mephi-ut/dc-thermal-logger/doc/collector/photos/IMG_20160623_171609.jpg

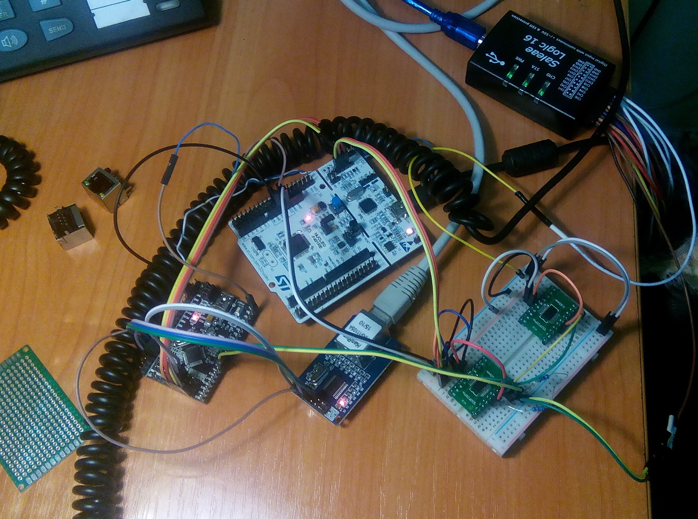
doc/collector/photos/IMG_20160623_171609.jpg
