mephi-ut/dc-thermal-logger/doc/collector/photos/IMG_20160622_171840.jpg

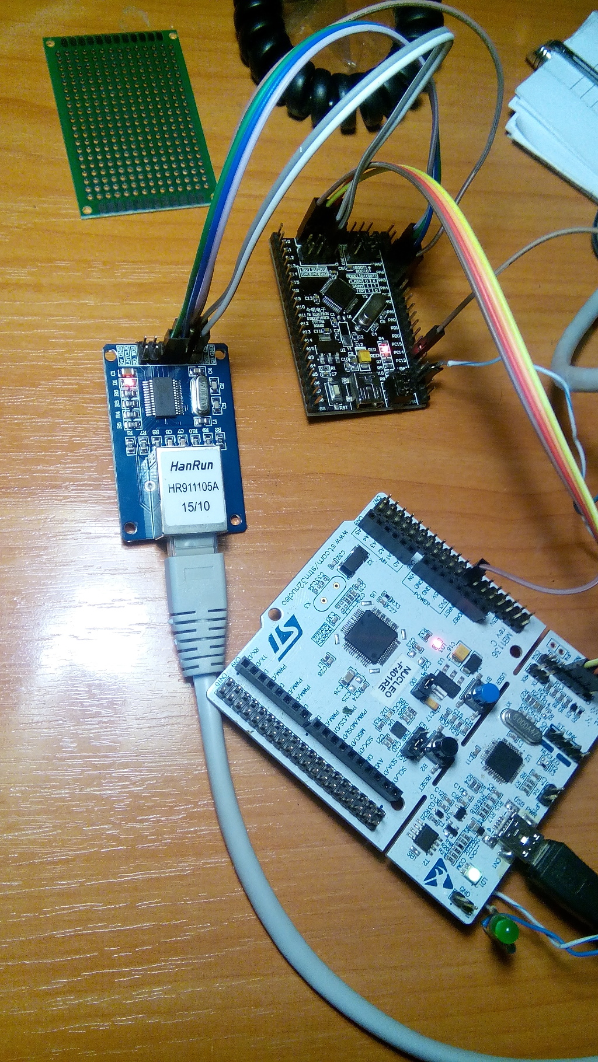
doc/collector/photos/IMG_20160622_171840.jpg
