mephi-ut/dc-thermal-logger/README.md

LICENSE: WTFPLv2

The purpose of this project is to monitor themperature in a lot of points of DC.

Operating principle:

scheme

Collector schematic:

colletor scheme

Thermal sensor schematic:

sensor scheme

A model photo:

collector photo
