mephi-ut/dc-thermal-logger/collector/firmware/firmware_Configuration.pdf

## firmware Project Configuration Report

# 1. Description

## 1.1. Project

Project Name | firmware
Board Name | firmware
Generated with: | STM32CubeMX 4.11.0
Date | 06/22/2016

## 1.2. MCU

MCU Series | STM32F1
MCU Line | STM32F103
MCU name | STM32F103C8Tx
MCU Package | LQFP48
MCU Pin number | 48

# 2. Pinout Configuration

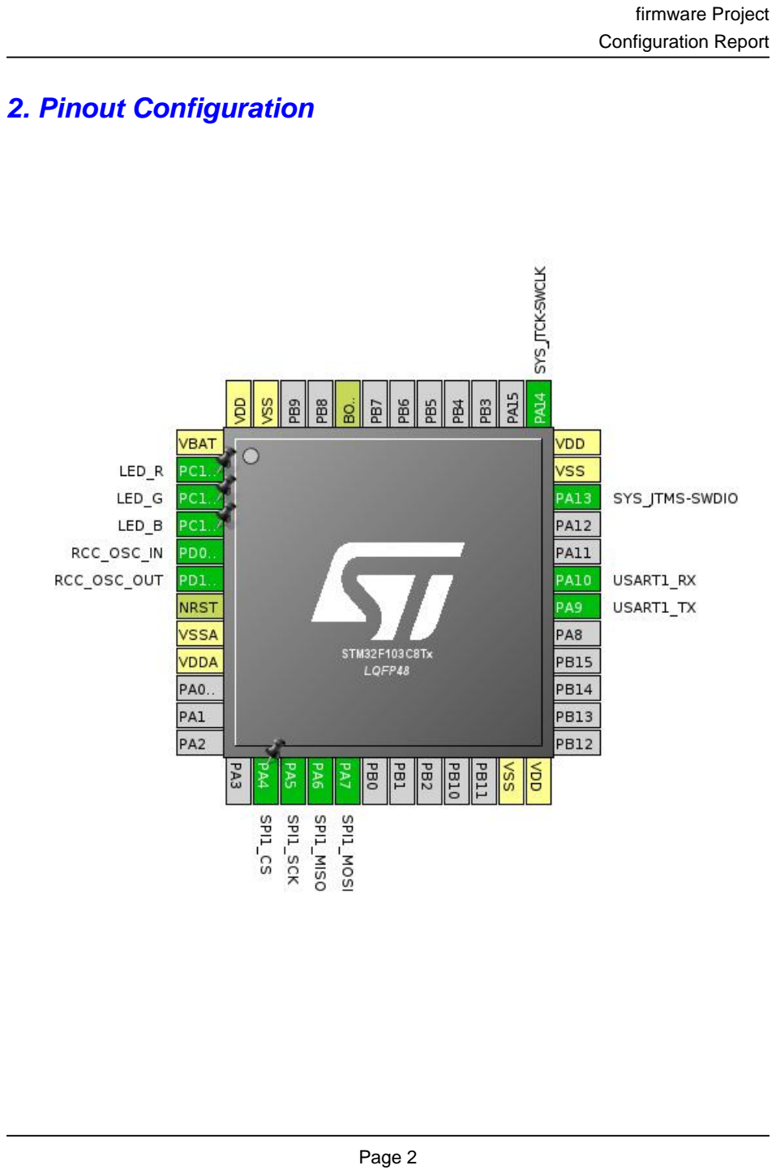
[picture p5: page 2]

# 3. Pins Configuration

Pin Number LQFP48 | Pin Name (function after reset) | Pin Type | Alternate Function(s) | Label
1 | VBAT | Power
2 | PC13-TAMPER-RTC * | I/O | GPIO_Output | LED_R
3 | PC14-OSC32_IN * | I/O | GPIO_Output | LED_G
4 | PC15-OSC32_OUT * | I/O | GPIO_Output | LED_B
5 | PD0-OSC_IN | I/O | RCC_OSC_IN
6 | PD1-OSC_OUT | I/O | RCC_OSC_OUT
7 | NRST | Reset
8 | VSSA | Power
9 | VDDA | Power
14 | PA4 * | I/O | GPIO_Output | SPI1_CS
15 | PA5 | I/O | SPI1_SCK
16 | PA6 | I/O | SPI1_MISO
17 | PA7 | I/O | SPI1_MOSI
23 | VSS | Power
24 | VDD | Power
30 | PA9 | I/O | USART1_TX
31 | PA10 | I/O | USART1_RX
34 | PA13 | I/O | SYS_JTMS-SWDIO
35 | VSS | Power
36 | VDD | Power
37 | PA14 | I/O | SYS_JTCK-SWCLK
44 | BOOT0 | Boot
47 | VSS | Power
48 | VDD | Power

## * The pin is affected with an I/O function

# 4. Clock Tree Configuration

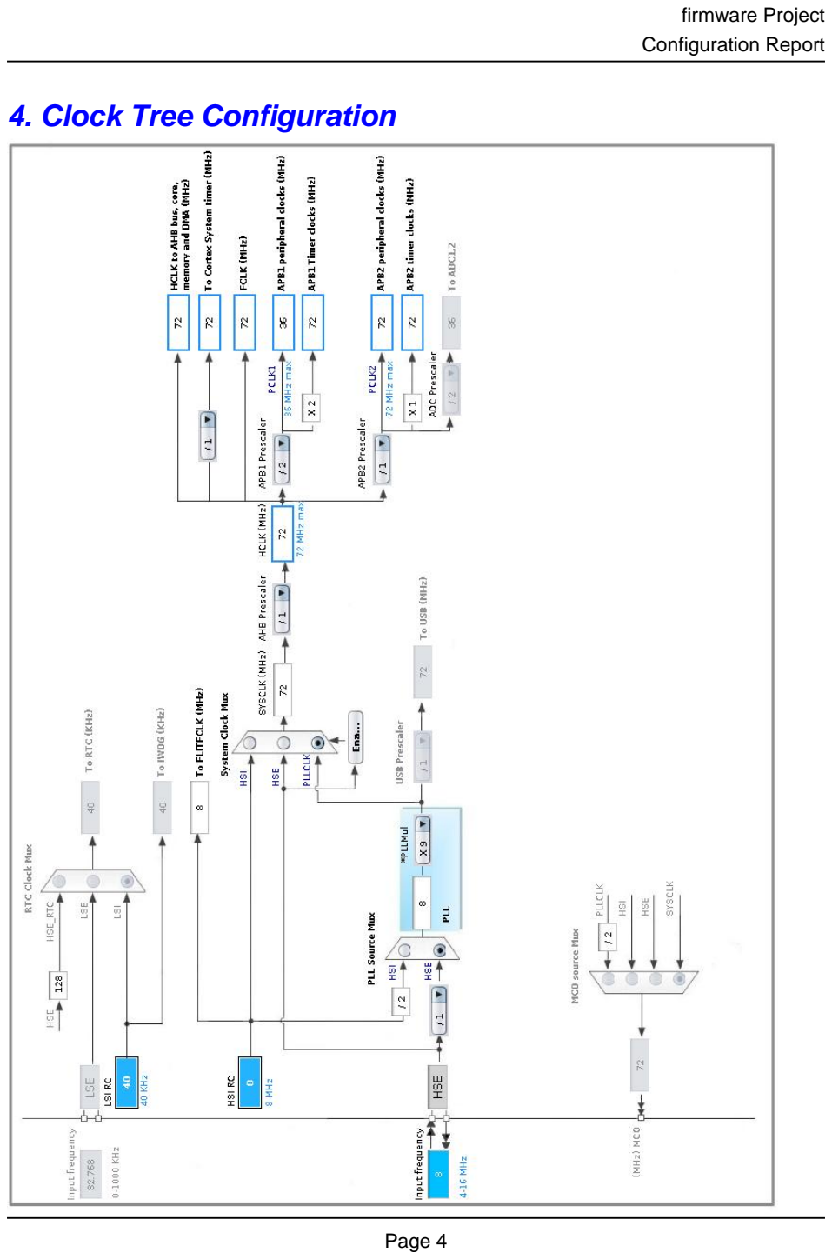
[picture p6: page 4]

# 5. IPs and Middleware Configuration

# 5.1. RCC

## High Speed Clock (HSE): Crystal/Ceramic Resonator

## 5.1.1. Parameter Settings:

### System Parameters:

VDD voltage (V) | 3.3
Prefetch Buffer | Enabled
Flash Latency(WS) | 2 WS (3 CPU cycle)

### RCC Parameters:

HSI Calibration Value | 16

# 5.2. SPI1

## Mode: Full-Duplex Master

## 5.2.1. Parameter Settings:

### Basic Parameters:

Frame Format | Motorola
Data Size | 8 Bits
First Bit | MSB First

### Clock Parameters:

Prescaler (for Baud Rate) | 4 *
Baud Rate | 18.0 MBits/s *
Clock Polarity (CPOL) | Low
Clock Phase (CPHA) | 1 Edge

### Advanced Parameters:

CRC Calculation | Disabled
NSS Signal Type | Software

# 5.3. SYS

## Debug: Serial-Wire

# 5.4. USART1

## Mode: Asynchronous

## 5.4.1. Parameter Settings:

### Basic Parameters:

Baud Rate | 115200
Word Length | 8 Bits (including Parity)
Parity | None
Stop Bits | 1

### Advanced Parameters:

Data Direction | Receive and Transmit
Over Sampling | 16 Samples

### * User modified value

# 6. System Configuration

# 6.1. GPIO configuration

IP | Pin | Signal | GPIO mode | GPIO pull/up pull down | Max Speed | User Label
RCC | PD0-OSC_IN | RCC_OSC_IN | n/a | n/a | n/a
| PD1-OSC_OUT | RCC_OSC_OUT | n/a | n/a | n/a
SPI1 | PA5 | SPI1_SCK | Alternate Function Push Pull | n/a | High *
| PA6 | SPI1_MISO | Input mode | No pull-up and no pull-down | n/a
| PA7 | SPI1_MOSI | Alternate Function Push Pull | n/a | High *
SYS | PA13 | SYS_JTMS-SWDIO | n/a | n/a | n/a
| PA14 | SYS_JTCK-SWCLK | n/a | n/a | n/a
USART1 | PA9 | USART1_TX | Alternate Function Push Pull | n/a | High *
| PA10 | USART1_RX | Input mode | No pull-up and no pull-down | n/a
GPIO | PC13-TAMPER-RTC | GPIO_Output | Output Push Pull | n/a | Low | LED_R
| PC14-OSC32_IN | GPIO_Output | Output Push Pull | n/a | Low | LED_G
| PC15-OSC32_OU T | GPIO_Output | Output Push Pull | n/a | Low | LED_B
| PA4 | GPIO_Output | Output Push Pull | n/a | Low | SPI1_CS

# 6.2. DMA configuration

DMA request | Stream | Direction | Priority
SPI1_RX | DMA1_Channel2 | Peripheral To Memory | Low
SPI1_TX | DMA1_Channel3 | Memory To Peripheral | Low
USART1_RX | DMA1_Channel5 | Peripheral To Memory | Low
USART1_TX | DMA1_Channel4 | Memory To Peripheral | Low

## SPI1_RX: DMA1_Channel2 DMA request Settings:

Mode: | Normal
Peripheral Increment: | Disable
Memory Increment: | Enable *
Peripheral Data Width: | Byte
Memory Data Width: | Byte

## SPI1_TX: DMA1_Channel3 DMA request Settings:

Mode: | Normal
Peripheral Increment: | Disable
Memory Increment: | Enable *
Peripheral Data Width: | Byte
Memory Data Width: | Byte

## USART1_RX: DMA1_Channel5 DMA request Settings:

Mode: | Normal
Peripheral Increment: | Disable
Memory Increment: | Enable *
Peripheral Data Width: | Byte
Memory Data Width: | Byte

## USART1_TX: DMA1_Channel4 DMA request Settings:

Mode: | Normal
Peripheral Increment: | Disable
Memory Increment: | Enable *
Peripheral Data Width: | Byte
Memory Data Width: | Byte

# 6.3. NVIC configuration

Interrupt Table | Enable | Preenmption Priority | SubPriority
System tick timer | true | 0 | 0
DMA1 channel2 global interrupt | true | 0 | 0
DMA1 channel3 global interrupt | true | 0 | 0
DMA1 channel4 global interrupt | true | 0 | 0
DMA1 channel5 global interrupt | true | 0 | 0
Non maskable interrupt | unused
Memory management fault | unused
Prefetch fault, memory access fault | unused
Undefined instruction or illegal state | unused
Debug monitor | unused
PVD interrupt through EXTI line 16 | unused
Flash global interrupt | unused
RCC global interrupt | unused
SPI1 global interrupt | unused
USART1 global interrupt | unused

### * User modified value

# 7. Power Plugin report

## 7.1. Microcontroller Selection

Series | STM32F1
Line | STM32F103
MCU | STM32F103C8Tx
Datasheet | 13587_Rev17

## 7.2. Parameter Selection

Temperature | 25
Vdd | 3.3

# 8. Software Project

## 8.1. Project Settings

Name | Value
Project Name | firmware
Project Folder | /home/xaionaro/dc-thermal-logger/collector/firmware
Toolchain / IDE | SW4STM32
Firmware Package Name and Version | STM32Cube FW_F1 V1.2.0

## 8.2. Code Generation Settings

Name | Value
STM32Cube Firmware Library Package | Copy all used libraries into the project folder
Generate peripheral initialization as a pair of '.c/.h' files | No
Backup previously generated files when re-generating | No
Delete previously generated files when not re-generated | Yes
Set all free pins as analog (to optimize the power consumption) | No
