mephi-ut/dc-thermal-logger/doc/collector/scheme.png

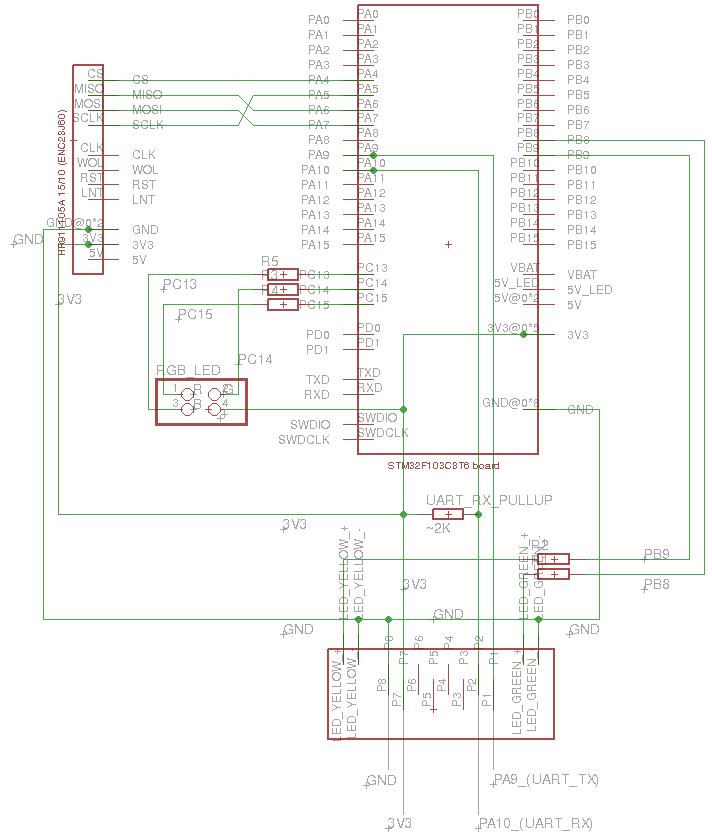
doc/collector/scheme.png
