mephi-ut/dc-thermal-logger/doc/thermal_sensor/scheme.png

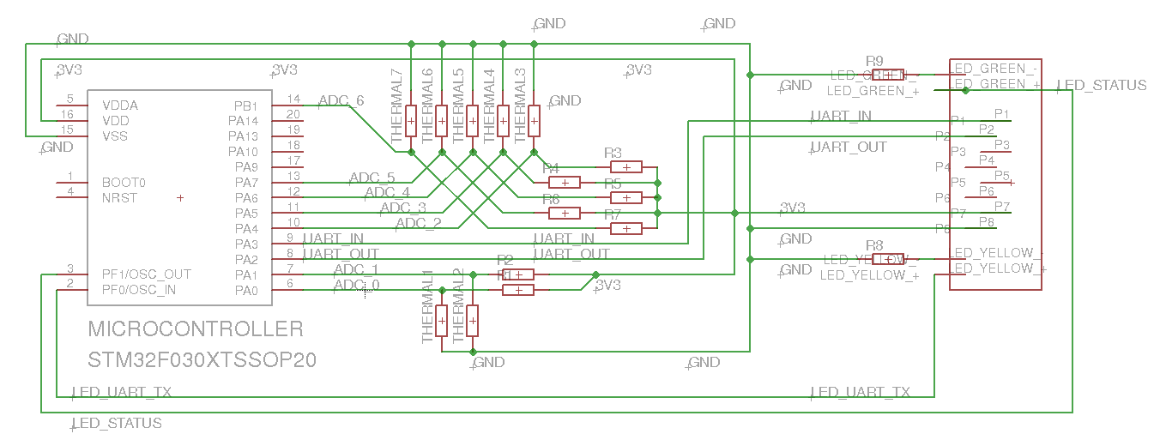
doc/thermal_sensor/scheme.png
