mephi-ut/dc-thermal-logger/doc/operating_principle.png

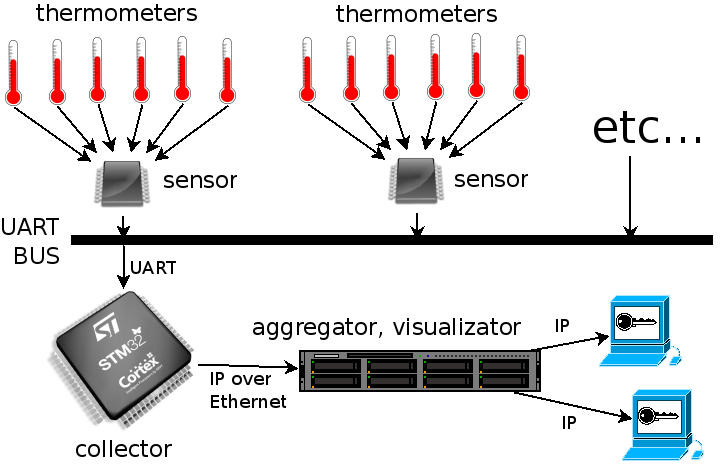
doc/operating_principle.png
