mephi-ut/dc-thermal-logger/collector/eagle/motherboard.brd

## EAGLE design collector/eagle/motherboard.brd (2016-06-24)

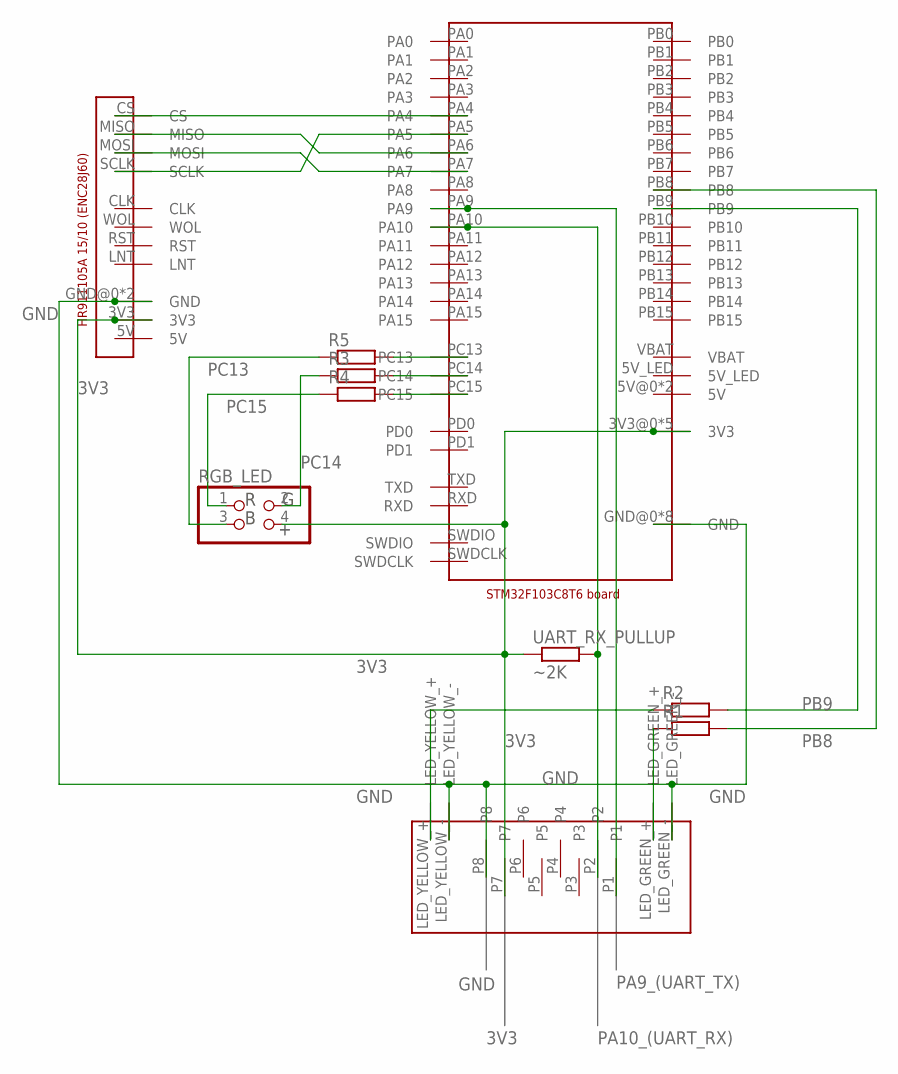
[picture p10: schematic motherboard.sch]

Parts:
R1, R2, R3, R4, R5: R-EU_R1206; R1206
RGB_LED: PINHD-2X2; 2X02
U$1: HANRUN_HR911105A_15/10
U$2: STM32F103C8T6_BOARD_BLACK
U$3: RJHSE-5481_(RJ45)
UART_RX_PULLUP: ~2K; R1206

Connections:
3V3: RGB_LED.4, U$1.3V3, U$2.3V3@0 (3V3), U$2.3V3@1 (3V3), U$2.3V3@2 (3V3), U$2.3V3@3 (3V3), U$2.3V3@4 (3V3), U$3.P7, UART_RX_PULLUP.1
GND: U$1.GND@0 (GND), U$1.GND@1 (GND), U$2.GND@0 (GND), U$2.GND@1 (GND), U$2.GND@2 (GND), U$2.GND@3 (GND), U$2.GND@4 (GND), U$2.GND@5 (GND), U$2.GND@6 (GND), U$2.GND@7 (GND), U$3.LED_GREEN_-, U$3.LED_YELLOW_-, U$3.P8
unnamed: U$1.CS, U$2.PA4
unnamed: U$1.SCLK, U$2.PA5
unnamed: U$1.MISO, U$2.PA6
unnamed: U$1.MOSI, U$2.PA7
unnamed: R1.1, U$3.LED_GREEN_+
unnamed: R4.2, U$2.PC15
unnamed: R3.2, U$2.PC14
unnamed: R5.2, U$2.PC13
PA9_(UART_TX): U$2.PA9, U$3.P1
PA10_(UART_RX): U$2.PA10, U$3.P2, UART_RX_PULLUP.2
PB8: R1.2, U$2.PB8
PB9: R2.2, U$2.PB9
PB9R: R2.1, U$3.LED_YELLOW_+
PC13: R5.1, RGB_LED.3
PC14: R3.1, RGB_LED.2
PC15: R4.1, RGB_LED.1

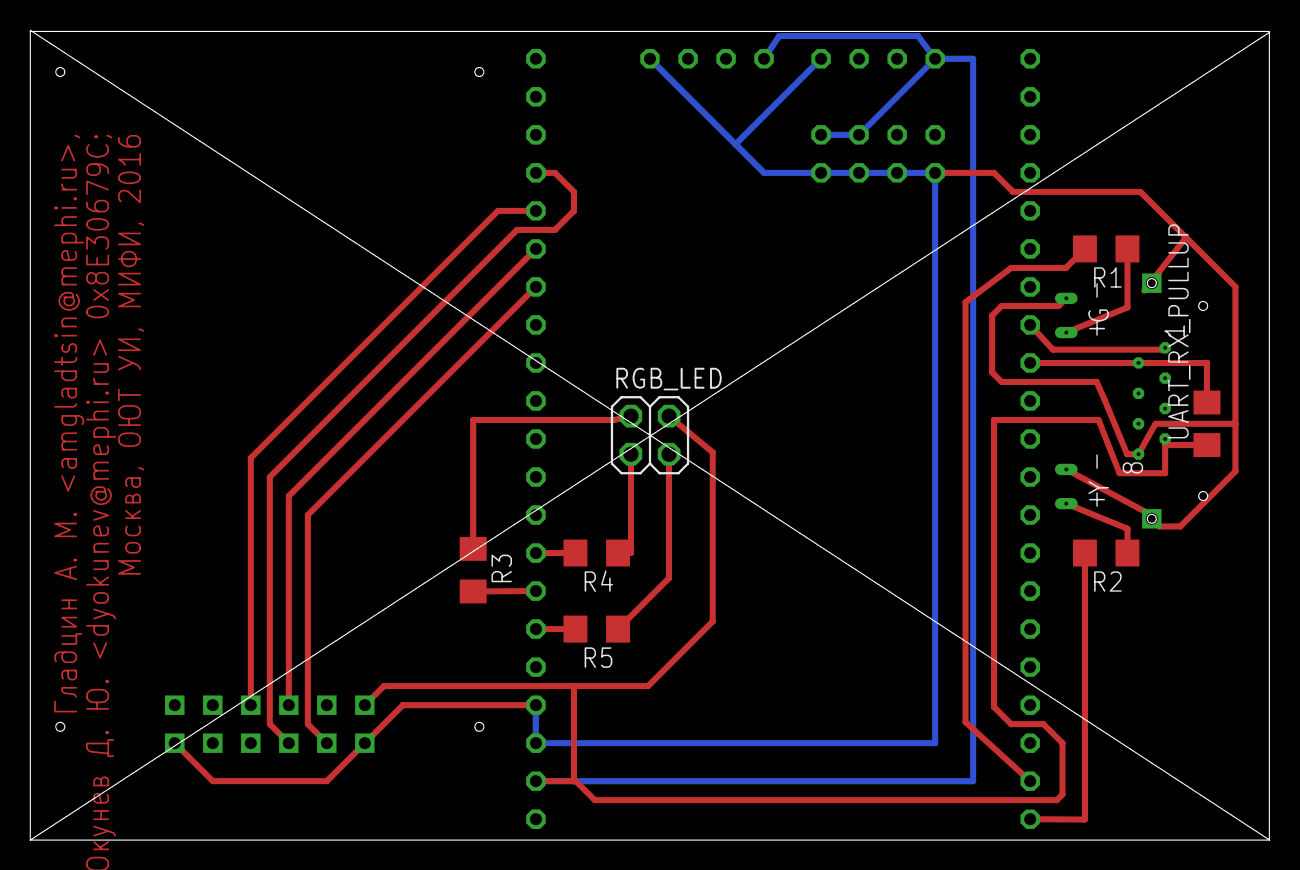
[picture p11: board motherboard.brd from above]

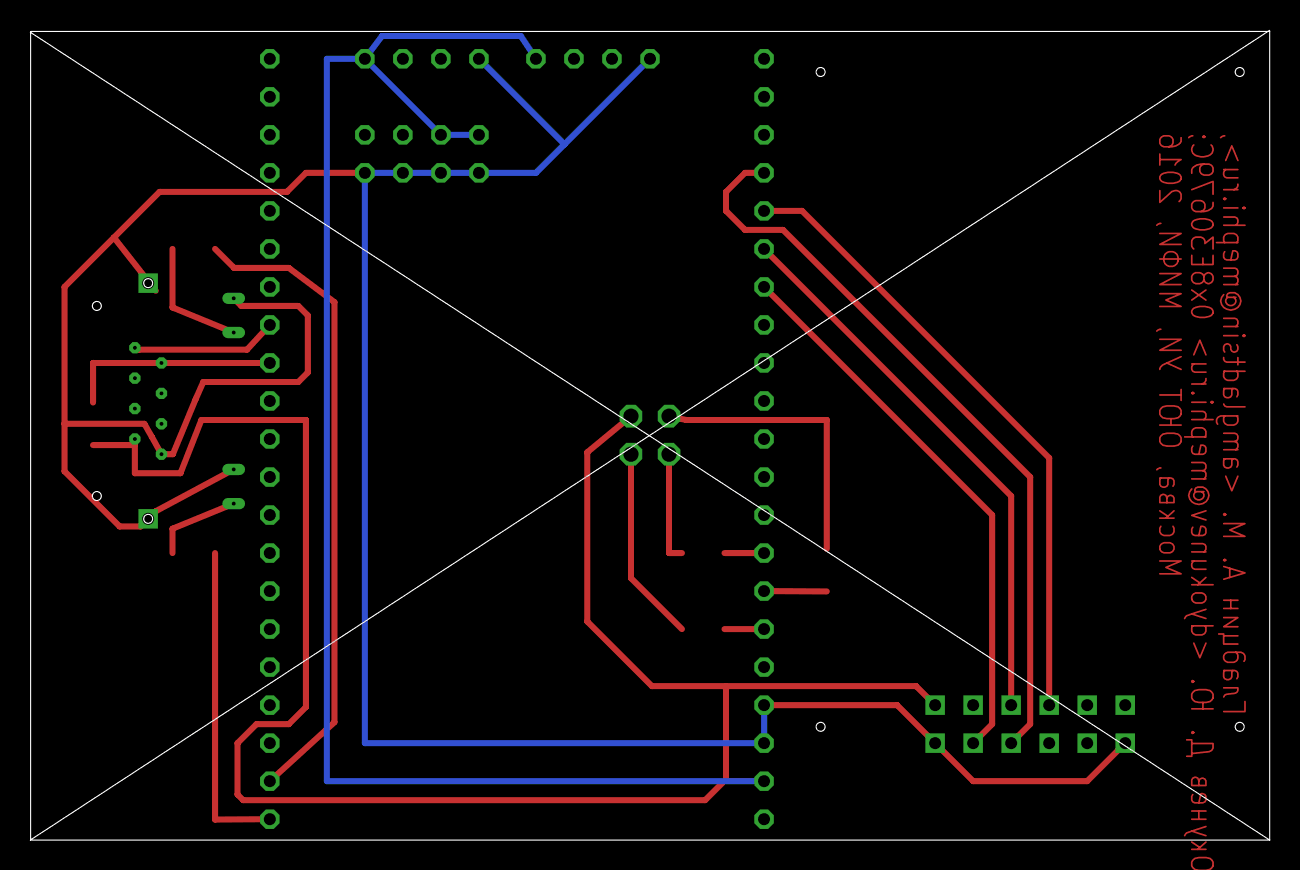
[picture p12: board motherboard.brd from below]

Board: 2 copper layers, 82.8 x 54.0 mm, 10 parts (2 on the bottom side), 18 nets.
