mephi-ut/dc-thermal-logger/doc/thermal_sensor/sensor.sch

## EAGLE design doc/thermal_sensor/sensor.sch (2016-06-22)

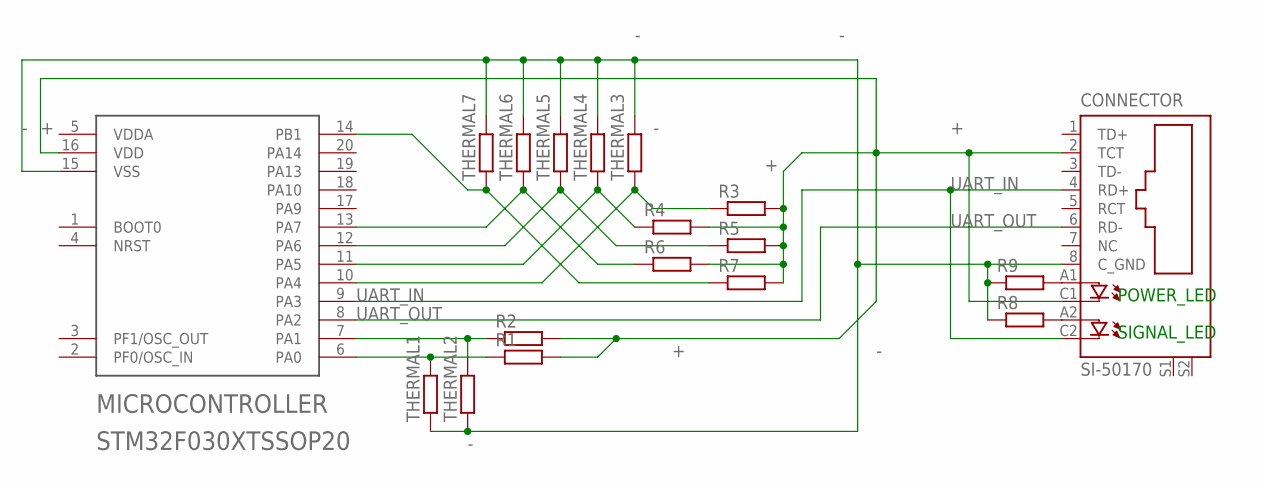
[picture p13: schematic sensor.sch]

Parts:
CONNECTOR: SI-50170
MICROCONTROLLER: STM32F030XTSSOP20; TSSOP-20
R1, R2, R3, R4, R5, R6, R7, R8, R9: R-EU_0204/5; 0204/5
THERMAL1, THERMAL2, THERMAL3, THERMAL4, THERMAL5, THERMAL6, THERMAL7: R-EU_V526-0; V526-0

Connections:
+: CONNECTOR.2 (TCT), CONNECTOR.C1 (C), MICROCONTROLLER.16 (VDD), R1.2, R2.2, R3.2, R4.2, R5.2, R6.2, R7.2
-: CONNECTOR.8 (C_GND), MICROCONTROLLER.15 (VSS), R8.1, R9.1, THERMAL1.1, THERMAL2.1, THERMAL3.2, THERMAL4.2, THERMAL5.2, THERMAL6.2, THERMAL7.2
unnamed: MICROCONTROLLER.10 (PA4), R3.1, THERMAL3.1
unnamed: CONNECTOR.A2 (A1), R8.2
unnamed: MICROCONTROLLER.11 (PA5), R4.1, THERMAL4.1
unnamed: CONNECTOR.A1 (A), R9.2
unnamed: MICROCONTROLLER.6 (PA0), R1.1, THERMAL1.2
unnamed: MICROCONTROLLER.7 (PA1), R2.1, THERMAL2.2
unnamed: MICROCONTROLLER.12 (PA6), R5.1, THERMAL5.1
unnamed: MICROCONTROLLER.13 (PA7), R6.1, THERMAL6.1
unnamed: MICROCONTROLLER.14 (PB1), R7.1, THERMAL7.1
UART_IN: CONNECTOR.4 (RD+), CONNECTOR.C2 (C1), MICROCONTROLLER.9 (PA3)
UART_OUT: CONNECTOR.6 (RD-), MICROCONTROLLER.8 (PA2)

Notes on the sheet:
POWER_LED
SIGNAL_LED
