mephi-ut/dc-thermal-logger/collector/firmware/firmware.ioc

Mcu.UserName=STM32F103C8Tx
PA10.Signal=USART1_RX
PA13.Signal=SYS_JTMS-SWDIO
PA14.Signal=SYS_JTCK-SWCLK
PA4.GPIO_Label=SPI1_CS
PA4.Signal=GPIO_Output
PA5.Signal=SPI1_SCK
PA6.Signal=SPI1_MISO
PA7.Signal=SPI1_MOSI
PA9.Signal=USART1_TX
PB9.GPIO_Label=LED_NETSEND
PB9.Signal=GPIO_Output
PC13-TAMPER-RTC.GPIO_Label=LED_R
PC13-TAMPER-RTC.Signal=GPIO_Output
PC14-OSC32_IN.GPIO_Label=LED_G
PC14-OSC32_IN.Signal=GPIO_Output
PC15-OSC32_OUT.GPIO_Label=LED_B
PC15-OSC32_OUT.Signal=GPIO_Output
PD0-OSC_IN.Signal=RCC_OSC_IN
PD1-OSC_OUT.Signal=RCC_OSC_OUT
