mephi-ut/dc-thermal-logger/sensor/firmware/Src/main.c

/**
  ******************************************************************************
  * File Name          : main.c
  * Description        : Main program body
  ******************************************************************************
  *
  * COPYRIGHT(c) 2016 STMicroelectronics
  *
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
  ******************************************************************************
  */
/* Includes ------------------------------------------------------------------*/
#include "stm32f0xx_hal.h"

/* USER CODE BEGIN Includes */

#ifndef MY_ID
#	error MY_ID is not defined. MY_ID can be defined via CFLAGS, for example "CFLAGS='-DMY_ID=1' make"
#endif

#define CHANNELS 8

typedef uint16_t dataitem_t;

dataitem_t adc_raw[CHANNELS];
uint32_t adc[CHANNELS];

struct sensorcommand {
	dataitem_t      command_id;
	dataitem_t       sensor_id;
	dataitem_t      channels;
	dataitem_t      channel[CHANNELS];
};
typedef struct sensorcommand sensorcommand_t;

struct collectorcommand {
	dataitem_t      command_id;
	dataitem_t       sensor_id;
};
typedef struct collectorcommand collectorcommand_t;

enum command_id {
	CMD_GETDATA = 1,
	CMD_SETDATA = 2,
};

/* USER CODE END Includes */

ADC_HandleTypeDef hadc;
DMA_HandleTypeDef hdma_adc;

UART_HandleTypeDef huart1;

/* USER CODE BEGIN PV */

/* USER CODE END PV */

void SystemClock_Config(void);
static void MX_GPIO_Init(void);
static void MX_DMA_Init(void);
static void MX_ADC_Init(void);
static void MX_USART1_UART_Init(void);

/* USER CODE BEGIN PFP */

#define HAL_Delay(a) HAL_Delay_my(a)

void HAL_Delay_my(uint32_t msec)
{
	while (msec--) {
		volatile int i;
		i=0; while(i++ < 350);
	}
}

void error (float error_num, char infinite)
{
	int i=0;
	while (i++ < error_num) {
		LED_STATUS_GPIO_Port->BSRR = LED_STATUS_Pin;
		HAL_Delay(300);
		LED_STATUS_GPIO_Port->BSRR = LED_STATUS_Pin << 16;
		HAL_Delay(200);
	}

	HAL_Delay(500);
	NVIC_SystemReset();

	return;
}

void blink(int times, int delay)
{
	int i = 0;
	while (i++ < times) {
		LED_STATUS_GPIO_Port->BSRR = LED_STATUS_Pin;
		HAL_Delay(delay);
		LED_STATUS_GPIO_Port->BSRR = LED_STATUS_Pin << 16;
		HAL_Delay(delay);
	}

	return;
}

/*
void HAL_ADC_ConvCpltCallback(ADC_HandleTypeDef* hadc)
{
}
*/

/* USER CODE END PFP */

int main(void)
{

  /* USER CODE BEGIN 1 */
	sensorcommand_t scmd;

  /* USER CODE END 1 */

  /* MCU Configuration----------------------------------------------------------*/

  /* Reset of all peripherals, Initializes the Flash interface and the Systick. */
  HAL_Init();

  /* Configure the system clock */
  SystemClock_Config();

  /* Initialize all configured peripherals */
  MX_GPIO_Init();
  MX_DMA_Init();
  MX_ADC_Init();
  MX_USART1_UART_Init();

  /* USER CODE BEGIN 2 */
	blink(1, 50);

#define ADC_DMA
#ifdef ADC_DMA
	{
		//HAL_ADC_Stop_DMA(&hadc);
		//HAL_ADC_Stop(&hadc);
		LED_STATUS_GPIO_Port->BSRR = LED_STATUS_Pin;
		int r = HAL_ADC_Start_DMA(&hadc, (uint32_t *)adc_raw, sizeof(adc)/sizeof(*adc));
		LED_STATUS_GPIO_Port->BSRR = LED_STATUS_Pin << 16;

		(void)r; // anti-warning
#	ifdef RESET_ON_DMA_ERROR
		if (r != HAL_OK)
			error(1+r, 0);
#	endif
	}
#else
	LED_STATUS_GPIO_Port->BSRR = LED_STATUS_Pin;
	int r = HAL_ADC_Start();
	LED_STATUS_GPIO_Port->BSRR = LED_STATUS_Pin << 16;

	(void)r; // anti-warning
#	ifdef RESET_ON_DMA_ERROR
	if (r != HAL_OK)
		error(1+r, 0);
#	endif

#	error is not implemented, yet
#endif

	scmd.command_id = CMD_SETDATA;
	scmd.sensor_id  = MY_ID;
	scmd.channels   = CHANNELS;

	LED_UART_TX_GPIO_Port->BSRR = LED_UART_TX_Pin;
	while(1) {
		//blink(1, 50);

		// Receiving command
		{
			//LED_STATUS_GPIO_Port->BSRR = LED_STATUS_Pin;
			collectorcommand_t ccmd;

			{
				int r = HAL_UART_Receive(&huart1, (uint8_t *)&ccmd, sizeof(ccmd), ~0);
				if (r != HAL_OK)
					error(1+r, 0);

				//while (!received);
			}

			if (ccmd.command_id != CMD_GETDATA)
				error(1, 0);

			if (ccmd.sensor_id  != MY_ID)
				continue;

			//LED_STATUS_GPIO_Port->BSRR = LED_STATUS_Pin << 16;
		}

		// Sending command
		{
			LED_UART_TX_GPIO_Port->BSRR = LED_UART_TX_Pin;

			int r;
			do {
				r = HAL_UART_Transmit(&huart1, (uint8_t *)&scmd, sizeof(scmd), ~0);
				switch (r) {
					case HAL_OK:
						break;
					case HAL_BUSY:
						blink(2, 200);
						blink(2, 100);
						blink(2, 50);
						break;
					default: 
						error(1+r, 0);
				}
			} while (r == HAL_BUSY);

			LED_UART_TX_GPIO_Port->BSRR = LED_UART_TX_Pin << 16;

#ifdef ADC_DMA
			//LED_STATUS_GPIO_Port->BSRR = LED_STATUS_Pin;
			//HAL_ADC_Start_DMA(&hadc, (uint32_t *)&scmd.channel, sizeof(scmd.channel)/sizeof(*scmd.channel));
			//LED_STATUS_GPIO_Port->BSRR = LED_STATUS_Pin << 16;
#endif
		}
	}

  /* USER CODE END 2 */

  /* Infinite loop */
}

/** System Clock Configuration
*/
void SystemClock_Config(void)
{

  RCC_OscInitTypeDef RCC_OscInitStruct;
  RCC_ClkInitTypeDef RCC_ClkInitStruct;
  RCC_PeriphCLKInitTypeDef PeriphClkInit;

  RCC_OscInitStruct.OscillatorType = RCC_OSCILLATORTYPE_HSI|RCC_OSCILLATORTYPE_HSI14;
  RCC_OscInitStruct.HSIState = RCC_HSI_ON;
  RCC_OscInitStruct.HSI14State = RCC_HSI14_ON;
  RCC_OscInitStruct.HSICalibrationValue = 16;
  RCC_OscInitStruct.HSI14CalibrationValue = 16;
  RCC_OscInitStruct.PLL.PLLState = RCC_PLL_ON;
  RCC_OscInitStruct.PLL.PLLSource = RCC_PLLSOURCE_HSI;
  RCC_OscInitStruct.PLL.PLLMUL = RCC_PLL_MUL12;
  RCC_OscInitStruct.PLL.PREDIV = RCC_PREDIV_DIV1;
  HAL_RCC_OscConfig(&RCC_OscInitStruct);

  RCC_ClkInitStruct.ClockType = RCC_CLOCKTYPE_SYSCLK;
  RCC_ClkInitStruct.SYSCLKSource = RCC_SYSCLKSOURCE_PLLCLK;
  RCC_ClkInitStruct.AHBCLKDivider = RCC_SYSCLK_DIV1;
  RCC_ClkInitStruct.APB1CLKDivider = RCC_HCLK_DIV1;
  HAL_RCC_ClockConfig(&RCC_ClkInitStruct, FLASH_LATENCY_1);

  PeriphClkInit.PeriphClockSelection = RCC_PERIPHCLK_USART1;
  PeriphClkInit.Usart1ClockSelection = RCC_USART1CLKSOURCE_PCLK1;
  HAL_RCCEx_PeriphCLKConfig(&PeriphClkInit);

  HAL_SYSTICK_Config(HAL_RCC_GetHCLKFreq()/1000);

  HAL_SYSTICK_CLKSourceConfig(SYSTICK_CLKSOURCE_HCLK);

  /* SysTick_IRQn interrupt configuration */
  HAL_NVIC_SetPriority(SysTick_IRQn, 0, 0);
}

/* ADC init function */
void MX_ADC_Init(void)
{

  ADC_ChannelConfTypeDef sConfig;

    /**Configure the global features of the ADC (Clock, Resolution, Data Alignment and number of conversion) 
    */
  hadc.Instance = ADC1;
  hadc.Init.ClockPrescaler = ADC_CLOCK_ASYNC;
  hadc.Init.Resolution = ADC_RESOLUTION12b;
  hadc.Init.DataAlign = ADC_DATAALIGN_RIGHT;
  hadc.Init.ScanConvMode = ADC_SCAN_DIRECTION_FORWARD;
  hadc.Init.EOCSelection = EOC_SINGLE_CONV;
  hadc.Init.LowPowerAutoWait = DISABLE;
  hadc.Init.LowPowerAutoPowerOff = DISABLE;
  hadc.Init.ContinuousConvMode = ENABLE;
  hadc.Init.DiscontinuousConvMode = DISABLE;
  hadc.Init.ExternalTrigConvEdge = ADC_EXTERNALTRIGCONVEDGE_NONE;
  hadc.Init.DMAContinuousRequests = ENABLE;
  hadc.Init.Overrun = OVR_DATA_PRESERVED;
  HAL_ADC_Init(&hadc);

    /**Configure for the selected ADC regular channel to be converted. 
    */
  sConfig.Channel = ADC_CHANNEL_0;
  sConfig.Rank = ADC_RANK_CHANNEL_NUMBER;
  sConfig.SamplingTime = ADC_SAMPLETIME_71CYCLES_5;
  HAL_ADC_ConfigChannel(&hadc, &sConfig);

    /**Configure for the selected ADC regular channel to be converted. 
    */
  sConfig.Channel = ADC_CHANNEL_1;
  HAL_ADC_ConfigChannel(&hadc, &sConfig);

    /**Configure for the selected ADC regular channel to be converted. 
    */
  sConfig.Channel = ADC_CHANNEL_4;
  HAL_ADC_ConfigChannel(&hadc, &sConfig);

    /**Configure for the selected ADC regular channel to be converted. 
    */
  sConfig.Channel = ADC_CHANNEL_5;
  HAL_ADC_ConfigChannel(&hadc, &sConfig);

    /**Configure for the selected ADC regular channel to be converted. 
    */
  sConfig.Channel = ADC_CHANNEL_6;
  HAL_ADC_ConfigChannel(&hadc, &sConfig);

    /**Configure for the selected ADC regular channel to be converted. 
    */
  sConfig.Channel = ADC_CHANNEL_7;
  HAL_ADC_ConfigChannel(&hadc, &sConfig);

    /**Configure for the selected ADC regular channel to be converted. 
    */
  sConfig.Channel = ADC_CHANNEL_9;
  HAL_ADC_ConfigChannel(&hadc, &sConfig);

    /**Configure for the selected ADC regular channel to be converted. 
    */
  sConfig.Channel = ADC_CHANNEL_TEMPSENSOR;
  HAL_ADC_ConfigChannel(&hadc, &sConfig);

}

/* USART1 init function */
void MX_USART1_UART_Init(void)
{

  huart1.Instance = USART1;
  huart1.Init.BaudRate = 115200;
  huart1.Init.WordLength = UART_WORDLENGTH_8B;
  huart1.Init.StopBits = UART_STOPBITS_1;
  huart1.Init.Parity = UART_PARITY_NONE;
  huart1.Init.Mode = UART_MODE_TX_RX;
  huart1.Init.HwFlowCtl = UART_HWCONTROL_NONE;
  huart1.Init.OverSampling = UART_OVERSAMPLING_16;
  huart1.Init.OneBitSampling = UART_ONEBIT_SAMPLING_DISABLED ;
  huart1.AdvancedInit.AdvFeatureInit = UART_ADVFEATURE_NO_INIT;
  HAL_UART_Init(&huart1);

}

/** 
  * Enable DMA controller clock
  */
void MX_DMA_Init(void) 
{
  /* DMA controller clock enable */
  __DMA1_CLK_ENABLE();

  /* DMA interrupt init */
  HAL_NVIC_SetPriority(DMA1_Channel1_IRQn, 0, 0);
  HAL_NVIC_EnableIRQ(DMA1_Channel1_IRQn);

}

/** Configure pins as 
        * Analog 
        * Input 
        * Output
        * EVENT_OUT
        * EXTI
*/
void MX_GPIO_Init(void)
{

  GPIO_InitTypeDef GPIO_InitStruct;

  /* GPIO Ports Clock Enable */
  __GPIOF_CLK_ENABLE();
  __GPIOA_CLK_ENABLE();
  __GPIOB_CLK_ENABLE();

  /*Configure GPIO pins : LED_STATUS_Pin LED_UART_TX_Pin */
  GPIO_InitStruct.Pin = LED_STATUS_Pin|LED_UART_TX_Pin;
  GPIO_InitStruct.Mode = GPIO_MODE_OUTPUT_PP;
  GPIO_InitStruct.Pull = GPIO_NOPULL;
  GPIO_InitStruct.Speed = GPIO_SPEED_LOW;
  HAL_GPIO_Init(GPIOF, &GPIO_InitStruct);

  /*Configure GPIO pins : LED_UART_TX2_Pin LED_STATUS2_Pin */
  GPIO_InitStruct.Pin = LED_UART_TX2_Pin|LED_STATUS2_Pin;
  GPIO_InitStruct.Mode = GPIO_MODE_OUTPUT_PP;
  GPIO_InitStruct.Pull = GPIO_NOPULL;
  GPIO_InitStruct.Speed = GPIO_SPEED_LOW;
  HAL_GPIO_Init(GPIOA, &GPIO_InitStruct);

}

#ifdef USE_FULL_ASSERT

/**
   * @brief Reports the name of the source file and the source line number
   * where the assert_param error has occurred.
   * @param file: pointer to the source file name
   * @param line: assert_param error line source number
   * @retval None
   */
void assert_failed(uint8_t* file, uint32_t line)
{
  /* USER CODE BEGIN 6 */
  /* User can add his own implementation to report the file name and line number,
    ex: printf("Wrong parameters value: file %s on line %d\r\n", file, line) */
  /* USER CODE END 6 */

}

#endif

/**
  * @}
  */ 

/**
  * @}
*/ 

/************************ (C) COPYRIGHT STMicroelectronics *****END OF FILE****/
