mephi-ut/dc-thermal-logger/(commit log)

2016-06-22 Fixed problem with too slow ethernet; added some docs
    [sensor.sch]
2016-06-22 Fixed UART Transmit
2016-06-23 Added initial skeleton for sensor firmware
2016-06-23 Added a workaround for ADC starting
    [main.c]
2016-06-23 Fixed slaves to work on one bus
    [main.c]
2016-06-24 Added motherboard board draft
    [motherboard.brd, motherboard.sch]
2016-06-24 Updated scheme of collector motherboard
    [motherboard.brd, motherboard.sch]
2016-06-24 Tiny fixes on colletor's motherboard
    [motherboard.brd, motherboard.sch]
2016-06-24 Updated sensor's scheme, colletor's photo and README.md
    [motherboard.sch, sensor.sch]
2016-06-24 Added a pull-up resistor for UART-RX of collector
    [motherboard.brd, motherboard.sch]
2016-06-28 Almost production ready for one channel per sensor
2016-06-28 Auto select sensor if it is alone in a group
2016-06-28 Added chart export button
2016-07-02 Added first two serverRack sensor groups
2016-07-02 Switched to per minute aggregation
2016-07-05 Few fixes
    * Don't parse raw history in DevMode
    * Minimal temperature = 10
    * Preserve displaying sensor after page refresh
2016-07-06 Added sensor names to minimal version
2016-07-11 Fixed compiling collector in ICMP echo server mode
    [main.c]
2016-07-26 Added logout button
2016-12-14 Disabled sensor 77
